ENGR155/macroprocessors/hardware.qmd

---
title: "Hardware"
description: "Selected electromagnet, sensor placement, and planned characterization."
---

## Electromagnet and Magnets

In the November 6 project discussion, the team selected the **Heyiarbeit JF-XP2520-12V**, described there as a 12 V DC, 25 mm diameter × 20 mm electromagnet. This replaces the hypothetical wound air-core coil used in earlier calculations. Selection does not establish measured lifting force, current, inductance, or thermal performance.

The team specified a **3/4 inch × 1/16 inch N42 fixed helper magnet** (approximately 19.05 mm × 1.59 mm). The suspended payload magnet was still undecided in that discussion. The moving magnet, carrier, and object together must total 10 g under the proposal.

Mount two Hall sensors above and below the electromagnet. Final helper-magnet placement, polarity, fit with the enclosed electromagnet, sensor saturation, and payload orientation need checking on the assembly.

## Course Boards and Planned Electronics

| Function | Board or planned part | Remaining check |
|---|---|---|
| Acquisition, DMA, gap estimate, web interface | STM32L432KC and course ESP8266 | Revised integration |
| Position PI and PWM | UPduino v3.1 | Revised controller |
| Field measurements | Two DRV5055 Hall sensors | Sensitivity and usable range |
| Three analog channels | MCP3204 at 3.3 V | Scan timing and noise |
| Current measurement | INA240A1 and 0.100 ohm shunt | Offset, gain, and heating |
| Power stage | UCC27511, MOSFET, flyback diode/clamp | Final ratings and wiring |
| Independent shutdown | E-stop and overcurrent comparator | Physical shutdown |
| Structure | Nonmagnetic frame, upper stop, catch tray | Final assembly evidence |

A gain of 20 and 0.100 ohm shunt give an ideal 2 V/A scale, or approximately 0.403 mA per 3.3 V, 12-bit ADC count. This is calculated scaling, not measured current accuracy.

## Characterization

Measure force versus gap and current with the complete assembly, including the helper magnet. Record cold/hot resistance, inductance, operating current, sensor headroom, and temperature. A contact holding-force rating does not establish force at a 10–20 mm gap.

The proposal's 500-turn, 8 ohm air-core example does not describe the selected electromagnet. Its calculated 1.178 A at 10 mm center distance must not be used as this device's measured operating current.

The [candidate BOM](hardware/bom.csv) and [earlier netlist](hardware/netlist.md) need reconciliation with final hardware. The proposal's $49 total is a planning allowance, not an updated purchase total. Final schematic, payload details, assembly photographs, and measured ratings remain to be added.
