ENGR155/macroprocessors/about.qmd

---
title: "About"
description: "Authors and scope of the ENGR 155 magnetic levitation project."
---

## The Project

This is our project for ENGR 155 at Harvey Mudd College. We are using the course MCU, FPGA, and ESP8266 boards to design a system that controls the height of a suspended magnetic object. The [system design](design.qmd) explains how we divide the work between the boards.

## Authors

### Stephen Kanti Mahanty

Stephen studies engineering at Harvey Mudd College and is interested in electrical and computer engineering. His experience includes PCB design and wireless networking, as well as an Electrical and Communications Engineering internship at Argonne National Laboratory.

[E155 Portfolio](https://stephenthecoder.github.io/engr155-portfolio/) | [GitHub](https://github.com/StephenTheCoder) | [LinkedIn](https://www.linkedin.com/in/stephen-kanti-mahanty/)

### Ben Lertwachara

Ben is a computer science major at Harvey Mudd College. His E155 portfolio contains his lab reports for the course.

[E155 Portfolio](https://jebeandiah.github.io/hmc-e155-portfolio/) | [GitHub](https://github.com/jebeandiah) | [LinkedIn](https://www.linkedin.com/in/benjamin-lertwachara-0b8251288/)

## Acknowledgements

The course materials and manufacturer datasheets are listed in the [technical references](docs/references.qmd). We used Codex to help prepare the implementation, documentation, and website. The [AI Use](ai.qmd) page describes this assistance.

## Website

This website is built with Quarto. Its layout follows the E155 course website and Carlos and Maynor's project website. The pages summarize the project, with links to more detailed engineering notes and source files.

[References](references.qmd)
