ENGR155/macroprocessors/docs/midpoint.md

# Midpoint status report framework

Current factual status: C firmware, HDL, protocol, tests, and implementation documentation are prepared. Parts are unselected and hardware operation has not been demonstrated. This status does not meet the working-hardware midpoint gate yet.

Prepare the course-length midpoint narrative with these sections, using actual dates and evidence:

1. Specifications and scope agreed with the instructor; any renegotiated interval or object.
2. Current functioning hardware and measured performance, with instrument captures.
3. MCU routine flow and FPGA acquisition/control diagram from docs/design.md.
4. A labeled CAD schematic of every assembled circuit, including interlocks and supplies.
5. The riskiest issue: Hall observability and transient compensation; current findings and next experiment.
6. Remaining work, owner, estimate, and dependency for each item in docs/course.md.

Append the relevant C and/or HDL source and explain how the demonstrated configuration was built. Keep absent measurements explicitly marked “not measured” rather than estimating completion percentages from file count. Preserve raw data and note firmware/FPGA configuration for reproducibility.
