ENGR155/macroprocessors/Project Proposal.docx

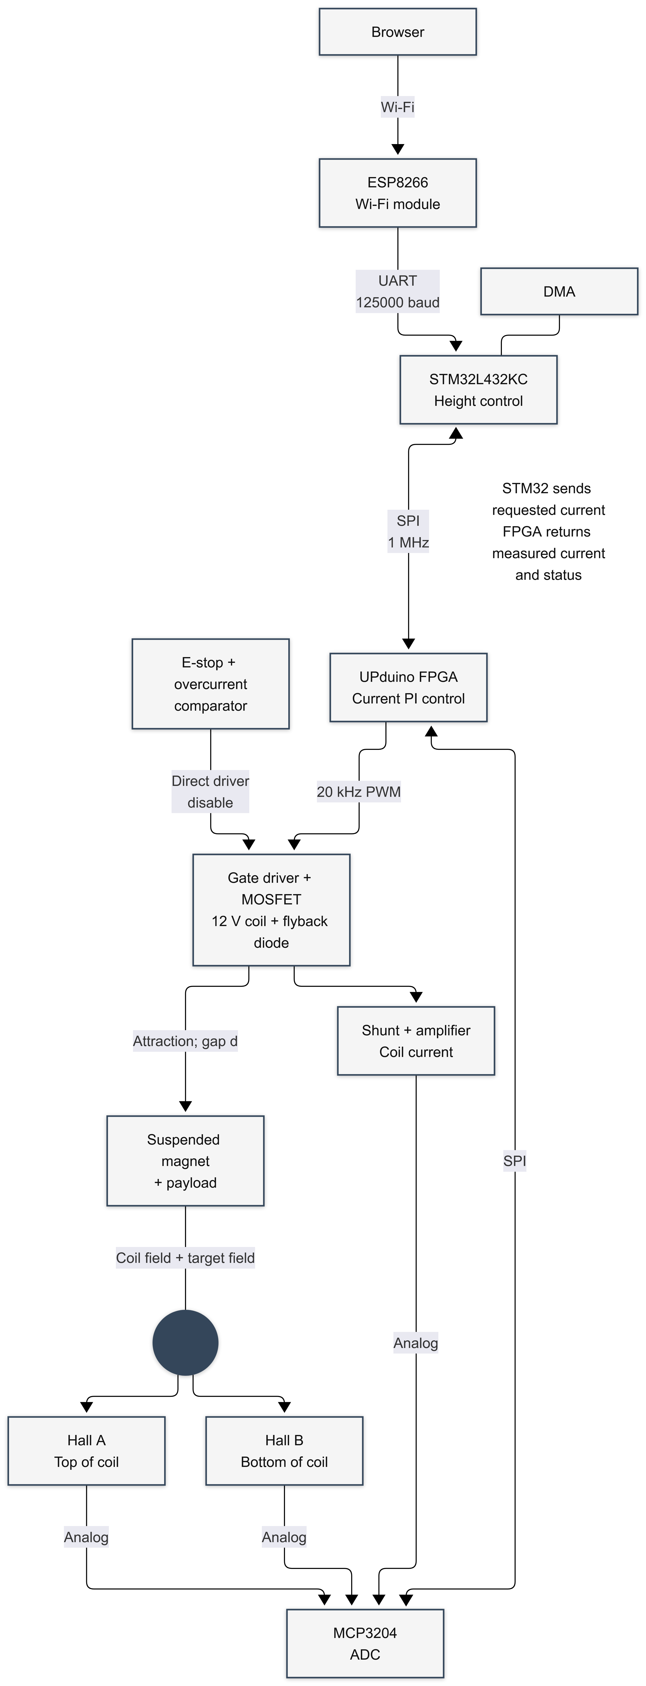
[picture p1: figure]

# Magnetic Levitation Project Proposal

Stephen Kanti Mahanty and Ben Lertwachara | ENGR 155

# Project overview

Our project will suspend a permanent magnet carrying an object below an electromagnet. The magnet, carrier and object will total 10 g. The webpage will command motion between 10 and 20 mm surface gaps. Two Hall sensors, mounted on opposite sides of the electromagnet, will measure magnetic field. We will combine both readings with measured coil current to estimate the target’s height and adjust current to hold it in place.

We will use the STM32L432KC MCU, UPduino FPGA and course ESP8266 Wi-Fi module. Gap d is the distance from the bottom of the coil to the top of the suspended magnet. We will demonstrate the round trips and position tolerance listed in the specifications and check gap with a ruler. The webpage will display requested gap, estimated gap, current and faults, and include a stop button.

# MCU and FPGA design

We will use shared control. The MCU will read the MCP3204 ADC over SPI using three separate channels: Hall sensor A, Hall sensor B and coil current. A timer will start scans at 5 kHz, with DMA moving SPI data. At 1 kHz, the MCU will estimate gap and use position and motion feedback to request a current. USART1 will connect to the ESP8266 at 125000 baud.

The MCU will send measured and requested current to the FPGA over SPI. The FPGA will run a 5 kHz PI current controller using DSP blocks and generate 20 kHz PWM. It will turn off drive after 50 ms without valid commands. A MOSFET, gate driver and flyback diode will switch the 12 V coil; a shunt and amplifier will measure current. An E-stop and overcurrent comparator will disable the driver directly. The MCU will also provide a drive-permit signal. SPI DMA is our new MCU peripheral use; the DSP current controller is our new FPGA logic; the ADC and magnetic sensing circuit are our new external hardware.

The MCU will read all three ADC channels and send measured and requested current to the FPGA. The FPGA will control current and generate PWM, as shown below.

SPI links carry commands and replies. The MCU drive-permit signal also gates the driver. Logic uses 3.3 V and shares ground with the coil circuit.

# Biggest challenge

Our biggest challenge is separating the target’s field from the coil’s field. We will mount Hall sensors A and B on opposite sides of the electromagnet and calibrate both readings at known gaps and coil currents on a plastic fixture. The MCU will read the sensors on separate ADC channels, combine their readings in software and compensate for the coil field using measured current. We will verify the estimated gap against ruler measurements over the 10–20 mm operating range. The ADC’s limited differential mode cannot directly subtract both full Hall outputs. A catch tray and upper stop will protect against falls and the target snapping upward.

# Current needed to lift an object at 12 V

Voltage alone does not tell us how much weight we can lift. We need the total mass m of the magnet, carrier and object, plus the coil geometry and magnet strength. For a first estimate, assume a small aligned permanent magnet below a thin air-core coil. Let N be the number of turns, a the mean coil radius, μ the magnet’s dipole moment and z the distance from the coil plane to the magnet’s center. Use meters and kilograms in the equations.

The coil field is B(z) = μ₀NIa² / [2(a² + z²)³ᐟ²]. The upward force is approximately F = μ|dB/dz| = K(z)I, where:

K(z) = 3μ₀Nμa²z / [2(a² + z²)⁵ᐟ²] and Ihold(z) = mg / K(z).

Here μ₀ = 4π × 10⁻⁷ H/m and g = 9.81 m/s². To move up by x mm from z₀, the final distance is z₁ = z₀ − x/1000. Current must provide enough force throughout the move, not just at the endpoint. To accelerate upward at aup, use I = m(g + aup)/K(z). The center distance z is different from surface gap d; we will convert between them using the actual coil and magnet dimensions.

## Example for a 10 g magnet and payload

For a sizing calculation, use N = 500 turns, a = 10 mm, μ = 0.050 A·m² and coil resistance R = 8 Ω. These are calculation assumptions, not selected parts. The table covers center distances of 10–20 mm; actual center distances will include the coil and magnet offsets from surface gap d. With PWM, duty cycle is D ≈ IR/12 and coil heating is P = I²R.

Final distance z | Holding current | 12 V duty | Coil heating
20 mm | 5.819 A | 388% | 270.9 W
15 mm | 2.643 A | 176% | 55.9 W
10 mm | 1.178 A | 79% | 11.1 W

For this example, 12 V / 8 Ω = 1.50 A is the ideal full-on current limit. Holding at z = 20 mm requires 5.819 A, so this example coil cannot deliver the required range at 12 V. A 10 mm upward move from z = 20 to 10 mm requires the largest holding current at the start. For a one-second move with equal acceleration and deceleration, aup = 4(0.010)/1² = 0.040 m/s²; the initial current becomes 5.842 A. A duty above 100% in the table means the supply cannot provide the required current.

We will select the final coil and magnet using measured force versus gap and current. The assembly must support the 10 g target over the full 10–20 mm surface-gap range at 12 V. We will measure hot resistance, inductance and temperature and check that the supply covers IR + L(dI/dt) and circuit losses. An iron core and finite magnet dimensions change the simple air-core estimate. Stable suspension will be verified by the demonstration specifications.

## Timing and measurement calculations

At 1 MHz SPI, a 24-clock ADC reading takes 24 μs. Including a 1 μs gap, current plus two Hall readings takes 75 μs. An 8-byte FPGA exchange takes about 68 μs with chip-select gaps. Together this uses 143 μs of a 200 μs scan period, leaving 57 μs for setup and processing. We will check the actual timing with a logic analyzer.

The 12-bit ADC has 4096 levels: 3.3 V / 4096 = 0.806 mV per count. With a 0.100 Ω shunt and gain of 20, current resolution is about 0.403 mA per count. At 1.18 A the shunt dissipates 0.139 W. A 24 MHz FPGA clock divided by 1200 gives 20 kHz PWM.

Stability calculation:

Assume a 10g mass held 15 mm below the coil. At the stationary position, acceleration is 0 and force is F = mg = 0.0981N. We set gap error x = d – 0.015 (d is gap in meters) and accumulated gap error η as the integral of x. We request current as iref = i0 + Kpx + Kiη

Current error is ei = iref – imeas so we request PWM duty as u = u0 + Kp(iref – i) + KI*(integral of iref - i)

If there is first-order lag with τ = 1 ms, then we have 0.001s³ + s² + 126.4s + 6400 = 0, which is stable as per the Routh-Horwitz definition of stability (all poles have negative real parts). We

Position Resolution – how closely we can see where it is

Stability – how closely we want it to be stable (calculations for loop) – start with continuous updates and find small signal gain, find out what happens when you transform – oppenheim and wilsky might have it

# Project specifications

These are proposed demonstration targets. We will use one magnet, carrier and object totaling 10 g. Professors can check each box during the demonstration using a ruler, stopwatch, webpage and scope or logic analyzer. Excellence includes all proficiency checks.

## Hardware and levitation specifications

## Proficiency

☐ Use the webpage to move from 20 to 10 mm and back five times without contact.

## Excellence

☐ Complete five 20-to-10 mm round trips, reaching within ±5 mm of each requested gap.

## Control and webpage specifications

## Proficiency

☐ Show requested gap, estimated gap, coil current and fault state on the webpage real-time on a graph (no visible latency between controlled object and the graph).

## Excellence

☐ Demonstrate visible noticeable movement of magnet through webpage control across controllable range.

Make specs for 1 specific mass

Maybe update constants from webpage(?)

# Bill of materials and budget

Parts | Planned cost
NUCLEO-L432KC, UPduino, ESP8266; bench supply and frame | Course kit / stockroom*
2 DRV5055 Hall sensors; MCP3204 ADC; INA240A1 amplifier | $16
0.100 Ω 1 W shunt; UCC27511 driver; MOSFET; flyback diode | $6
Coil, magnet and carrier; adapters, resistors and capacitors | $14
Fuse and connectors*; shipping and tax allowance | $3 + $10
Estimated total | $49

*Stockroom availability is unconfirmed. Costs are allowances; final coil and power-switch parts depend on testing.

# Schedule and division of work

Week | Stephen | Ben
1–2 | Measure coil force; build driver and FPGA PWM | Read ADC; calibrate Hall and current readings
3–4 | Tune FPGA current PI; build frame and stops | Validate gap estimate; tune MCU height control
5–6 | Webpage, shutdown tests and schematic | Motion tests, checkoff measurements and report
