ENGR155/macroprocessors/overleaf_10mm/calculation_summary.pdf

## Magnetic Levitation at a Nominal 10 mm Distance

Abridged Calculation: Position PI Driving PWM Directly

ENGR 155 calculation notes

Result. Reducing the distance improves the available lifting force. For the proposal’s illustrative coil, a 10 mm center distance requires about 1.178 A and 78.5% ideal duty at 12 V. However, assuming an inductance of 10 mH and negligible passive mechanical damping, the position PI loop remains unstable for every choice of PI gains in the continuous-time model derived below. The inductance and damping are assumptions, not measurements.

## 1 Geometry, architecture, and assumptions

The suspended magnet, carrier, and payload have total mass m = 0.010 kg. The desired surface gap is d0 = 0.010 m, measured from the lower coil face to the upper magnet face. The thin-coil/dipole model instead uses the distance z from the coil plane to the magnet center:

z = d + ∆g, | z0 = d0 + ∆g. | (1)

For a coil represented by its axial midplane and a magnet represented by its geometric center, ∆g is approximately half the coil thickness plus half the magnet height. Its value must be determined from the actual geometry.

Distance convention for the numbers below. To reproduce the current 10 mm calculation, the numerical illustration sets z0 = 10 mm. This equals a 10 mm surface gap only in the zero-offset, thin-coil/point-magnet idealization. For a real 10 mm surface gap, substitute the actual z0 = 10 mm + ∆g into the same equations.

The controller is position PI only: measured gap error produces PWM duty directly. There is no current reference or current-feedback controller. Current can still be measured for field compensation, telemetry, and protection. The FPGA executes the position PI and PWM; the MCU handles ADC acquisition, DMA, the gap estimate, and the web interface through the Wi-Fi module.

The numerical sizing assumptions from the proposal are

Symbol | Meaning | Value used
m | Total suspended mass | 0.010 kg
g | Gravitational acceleration | 9.81 m/s

2
N | Coil turns | 500
a | Mean coil radius | 0.010 m
µ | Magnet dipole moment | 0.050 A m²
R | Coil resistance | 8.0 Ω
Vs | Supply voltage | 12.0 V
L | Differential coil inductance | 0.010 H, assumed
c | Passive mechanical damping | 0 N s/m, approximation

The model assumes an aligned permanent dipole, a thin air-core coil, small motions near equilibrium, and an averaged PWM voltage Vsu in continuous conduction. It neglects driver and diode drops, thermal changes, magnetic saturation, hysteresis, and unmodeled structural motion. A final core-equipped coil must be characterized locally rather than assigned these air-core slopes.

## 2 Holding force, current, and power

The standard axial coil field and aligned-dipole approximation give

B(z) = µ0NIa²
2(a

2 + z

2)

3/2

, | | (2)

F(z, I) ≃ µ

dB
dz
= K(z)I, | | (3)

K(z) = 3µ0Nµa²
z
2(a

2 + z

2)

5/2

, | µ0 = 4π × 10−7 H/m. | (4)

The field expression follows the current-loop model in OpenStax [1]; the force relation is the dipole approximation used in the proposal. At z0 = 0.010 m,

K(z0) = 0.0833041 N/A, | (5)
F0 = mg = 0.0981 N, | (6)

i0 =

mg
K(z0)
= 1.17761 A, | (7)

u0 ≃

Ri0
Vs
= 0.78508, | (8)

Pcoil = i

2
0R ≃ 11.09W. | (9)

The ideal full-on current is Vs/R = 1.50 A, so this nominal point is statically feasible in the ideal model. It leaves about 21.5 percentage points of upward duty headroom; it does not establish thermal acceptability, dynamic force headroom, or closed-loop stability.

## 3 Small-signal force gains and mechanics

Define x = d − d0 and j = i − i0. Positive x is downward motion, away from the coil. A first-order Taylor expansion of upward magnetic force is

F ≃ mg − kxx + kf j, | kf =
| ∂F ∂i
| 0
, | kx = −
| ∂F ∂d
0
. | (10)

Because z = d + ∆g with fixed geometry, dz/dd = 1. For the illustrative force law,

kf = K(z0), | | (11)
dK
dz

= K(z)

1
z

−

| 5z a 2 + z
| 2
| , | (12)
kx = mg
5z0
a | 2 + z

2/0−

| 1 z0
| . | (13)

Substitution gives
kf = 0.0833041 N/A, | kx = 14.715 N/m. | (14)

Newton’s law, with downward displacement positive, is

mx¨ + cx˙ − kxx + kf j = 0. | (15)

If current were held fixed and c = 0, the mechanical poles would be s = ±

p
kx/m = ±38.36 s−1
. The
positive pole represents a growing displacement. This is a fixed-current mechanical comparison, not the complete voltage-driven plant.

## 4 Position PI and the uncontrolled coil current

Let u ∈ [0, 1] be duty fraction. For a constant target define

u = u0 + Kpx + Kiη, | η˙ = x. | (16)

The positive sign increases attraction when the object is too far from the coil. Kp has units m−1
| | , Ki has
units m−1
s

−1
, and η has units m s. For a changing requested gap r(t), the controller error is e = d − r.

Coil current is a plant state, even though it has no controller. Including motion-induced voltage, the local electrical equation is

L˙j + Rj − kfx˙ = Vsδu, | δu = u − u0. | (17)

The coupling term follows from reciprocal magnetic coenergy: the downward magnetic force is −F, so ∂λ/∂d = ∂(−F)/∂i = −kf , where λ is flux linkage. Consequently δv = Rj + L˙j − kfx˙. This is the energy-based electromechanical modeling method in Woodson and Melcher [2]. The mechanical damping c excludes this explicitly modeled coil coupling. If motion-induced voltage is negligible, omit the −kfx˙ term; then the +k

2
f

term below also disappears.

## 5 Laplace transform and stability calculation

With zero initial conditions, the transformed equations are

(ms² + cs − kx)X + kfJ = 0, | (18)
(Ls + R)J − kf sX = Vs∆U, | (19)

∆U =

| Kp + Ki s
X. (20)

Eliminating J and ∆U gives

s

(ms² + cs − kx)(Ls + R) + k

2
f

s

+ kfVs(Kps + Ki) = 0. | (21)

Thus the characteristic polynomial is

p(s) = mLs⁴ + (mR + cL)s

3 + (cR − kxL + k

2
f

)s

2

+ (kfVsKp − kxR)s + kfVsKi .

(22)

The four states are position, velocity, current, and accumulated position error. Taking a transform changes the representation, not the physical stability. Laplace and feedback foundations are in Oppenheim and Willsky [4].

For p(s) = A4s

4 + A3s

3 + A2s

2 + A1s + A0, strict stability requires

A4, A3, A2, A1, A0 > 0, | (23)
A3A2 − A4A1 > 0, | (24)

A3A2A1 − A4A

2
1 − A

2
3A0 > 0. | (25)

These are the quartic Routh–Hurwitz conditions [3]. Two necessary conditions are

Kp >

kxR
kfVs

, cR + k

2
f > kxL. | (26)

The second condition is independent of the PI gains.

For L = 10 mH and c = 0, the numerical polynomial is

p(s) = 0.0001s

4 + 0.08s

3 − 0.140210s

2

+ (0.999649Kp − 117.72)s + 0.999649Ki .

(27)

Its s

2
coefficient is negative for every Kp, Ki

. Therefore no position PI tuning can make this particular continuous-time model strictly stable. The necessary proportional-gain threshold, Kp > 117.76 m−1 ,
cannot repair the negative coefficient.

For illustration only, choose Kp = 150 m−1 and Ki = 100 m−1
s

−1
. Then

p(s) = 0.0001s

4 + 0.08s

3 − 0.140210s

2 + 32.2273s + 99.9649, | (28)

whose roots are
s = −802.247, | −2.9963, | 2.6214 ± j 20.2237 s−1
. | (29)

The oscillatory mode grows as e

2.6214t
, with an amplitude e-folding time of about 0.381 s. These are unstable example gains, not recommended firmware settings.

The necessary electrical/damping condition can also be written

c = 0 : | L < k
| 2 f kx
= 0.4716 mH, | (30)
L = 10 mH : | c >

kxL − k

| | 2 f
| R
= 0.01753 N s/m. | (31)

Passing either applicable threshold is necessary but not sufficient: all Routh inequalities must still pass. This does not prove that every physical PI-controlled levitator is unstable; it identifies what this assumed plant cannot achieve.

## 6 Digital implementation and the z-transform

For an illustrative 1 kHz position update, T = 0.001 s, choose the explicit timing convention

δu[k] = Kpe[k] + Kiη[k], | (32)
η[k + 1] = η[k] + T e[k]. | (33)

This gives C(z) = Kp + KiT /(z −1). Using the updated accumulator in the same sample instead would give a different discrete controller.

To check the held actuator correctly, define q = [x, x, j ˙ ]

T:

q˙ = Aq + Bδu, A =

0 | 1 | 0
kx/m −c/m −kf /m
0 | kf /L | −R/L
- , B =

0
0
Vs/L
- , C =

h

1 0 0i
. (34)

The exact zero-order-held plant has

Ad = e

AT , | Bd =

Z T

0

e

| | AτB dτ, | (35)

and the sampled closed-loop state matrix, with zero additional computation delay, is

M =

"
Ad + BdKpC BdKi
| T C | 1

| | . | (36)

The implemented loop is stable only if every eigenvalue of M is inside the unit circle. Merely substituting z = e

sT for the continuous closed-loop poles does not model a separately sampled controller and held actuator. Additional sensor filtering, communication, and computation delay must be included before selecting firmware gains.

For the same illustrative plant and the unstable example gains above, the eigenvalues of this sampled matrix are
z = 0.447767, | 0.997019, | 1.002880 ± j 0.020241. | (37)

The complex pair has magnitude approximately 1.00308, exceeding one. Thus the explicitly defined 1 kHz sampled implementation is also unstable.

## 7 Measurements and the position-tolerance requirement

For the final coil at the actual 10 mm surface gap, measure the holding current and hot resistance, differential inductance, and local force slopes:

kf ≃

F(d0, i0 + ∆i) − F(d0, i0 − ∆i) 2∆i

| | , | (38)
kx ≃ −

F(d0 + ∆d, i0) − F(d0 − ∆d, i0)
| | 2∆d
| | . | (39)

Estimate passive damping without counting the modeled coil-induced damping twice. Recalculate the continuous and sampled poles with the measured values. Duty limits and integrator anti-windup are necessary practical details, but they do not turn an unstable linear PI design into a stable small-signal loop.

Specify a true-position tolerance and a recovery time separately; for example, |d − r| ≤ 0.5 mm after a defined disturbance and settling interval. That example is not a demonstrated performance claim. A stable, unsaturated PI loop can reject constant disturbances in its measured position, while sensor bias, noise, quantization, and saturation still limit the true position. The proposal’s current demonstration band is ±5 mm. No settling time or position band can be certified from the unstable example above.

## References

[1] OpenStax, University Physics, Volume 2, Sec. 12.4, “Magnetic Field of a Current Loop.” https://openstax.org/books/university-physics-volume-2/pages/12-4-magnetic-field-of-a-current-loop (https://openstax.org/books/university-physics-volume-2/pages/12-4-magnetic-field-of-a-current-loop)
[2] H. H. Woodson and J. R. Melcher, Electromechanical Dynamics, Part I, Chs. 3 and 5. MIT OpenCourseWare. https://ocw.mit.edu/courses/res-6-003-electromechanical-dynamics-spring-2009/pages/part-i/ (https://ocw.mit.edu/courses/res-6-003-electromechanical-dynamics-spring-2009/pages/part-i/)
[3] University of Illinois, ECE 486 Handbook, Lecture 7, “Routh–Hurwitz Stability Criterion.” https: //courses.physics.illinois.edu/ece486/sp2026/documentation/handbook/lec07.html
[4] A. V. Oppenheim, A. S. Willsky, with S. H. Nawab, Signals and Systems, 2nd ed., Prentice Hall, 1997, Chs. 9 (Laplace), 10 (z-transform), and 11 (feedback). MIT reading guide: https://ocw.mit.edu/courses/6-003-signals-and-systems-fall-2011/pages/readings/
