ENGR155/macroprocessors/overleaf_10mm/assets/system_architecture.png

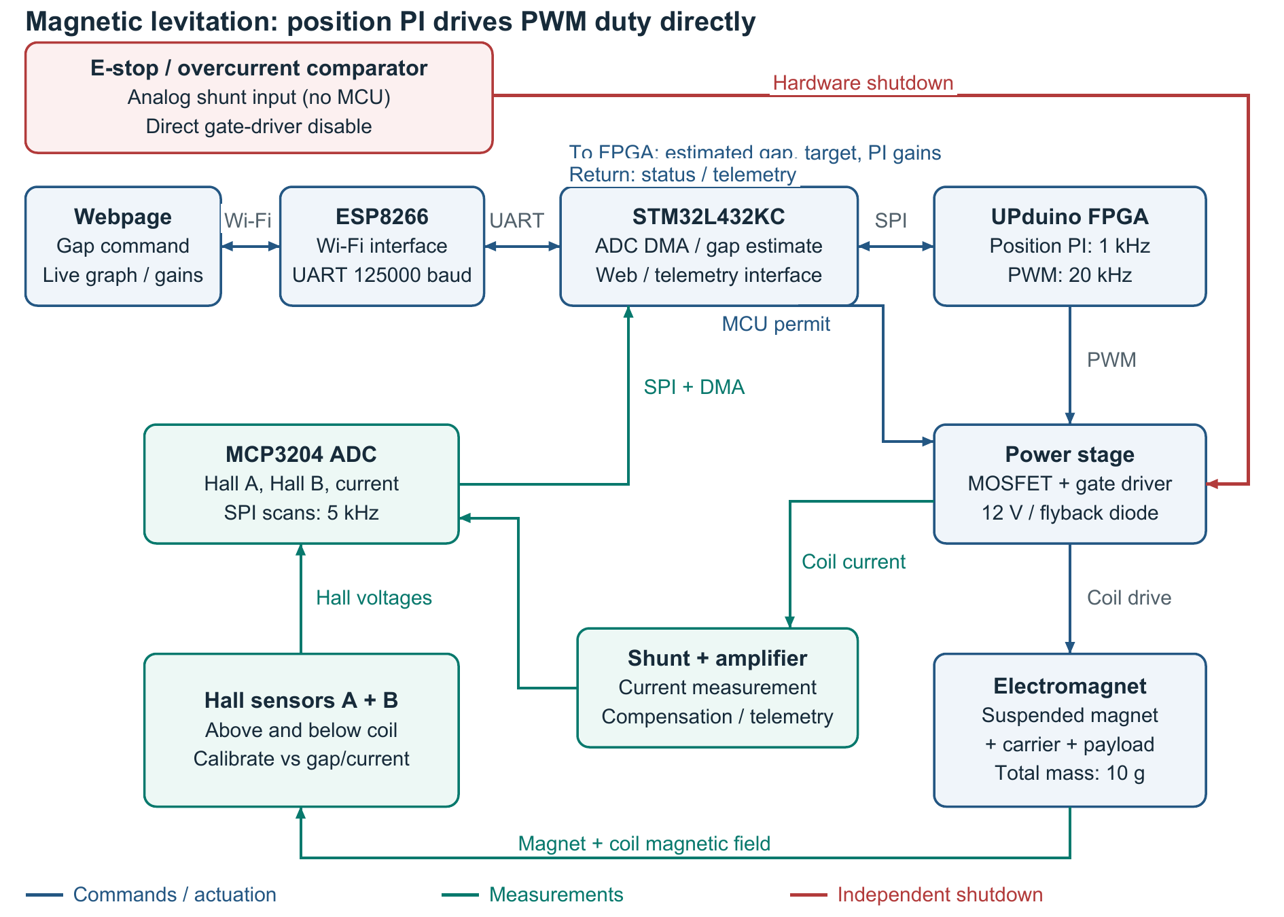
overleaf_10mm/assets/system_architecture.png
