ENGR155/macroprocessors/cad/testbox1_box/fabricated_parts_assembled.step

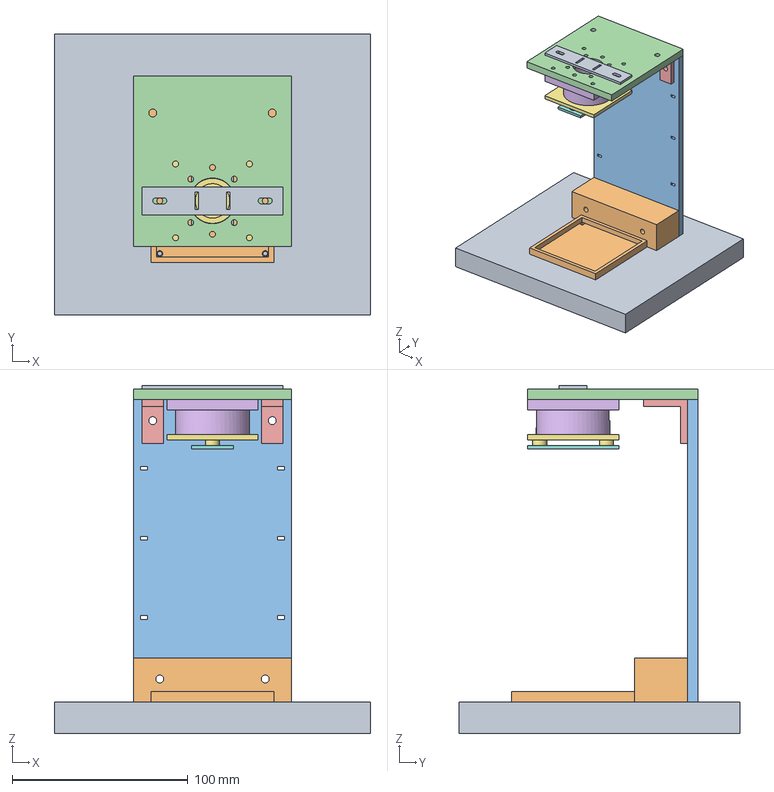
[picture p4: CAD file, 2026-11-11]
cad/testbox1_box/fabricated_parts_assembled.step
180.0 x 160.0 x 198.0 mm
