ENGR155/macroprocessors/cad/testbox1_box/parts/REF_upper_Hall_allowance.step

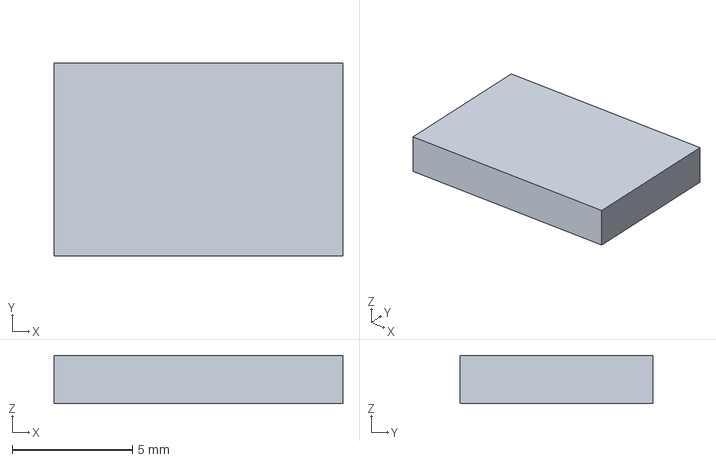
[picture p5: CAD file, 2026-11-11]
cad/testbox1_box/parts/REF_upper_Hall_allowance.step
12.0 x 8.00 x 2.00 mm
