ENGR155/macroprocessors/cad/testbox1_box/printed_version/parts/06_em_cradle.step

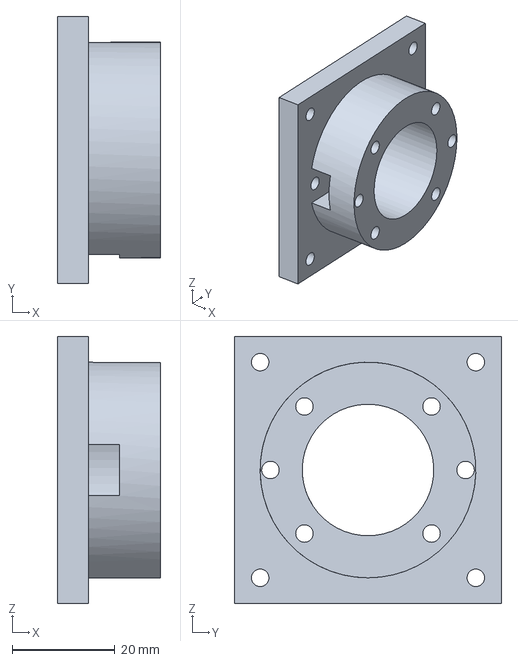
[picture p6: CAD file, 2026-11-11]
cad/testbox1_box/printed_version/parts/06_em_cradle.step
20.0 x 52.0 x 52.0 mm
