ENGR155/macroprocessors/cad/testbox1_box/parts/REF_helper_19p05x1p5875.step

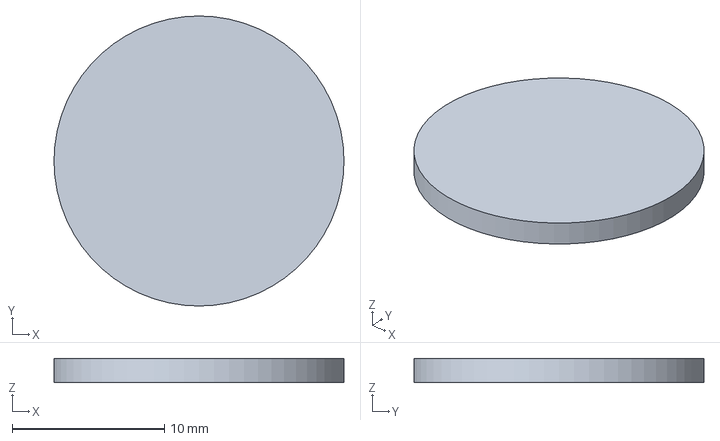
[picture p7: CAD file, 2026-11-11]
cad/testbox1_box/parts/REF_helper_19p05x1p5875.step
19.1 x 19.1 x 1.59 mm
