ENGR155/macroprocessors/cad/testbox1_box/printed_version/parts/05_angle_bracket_right.step

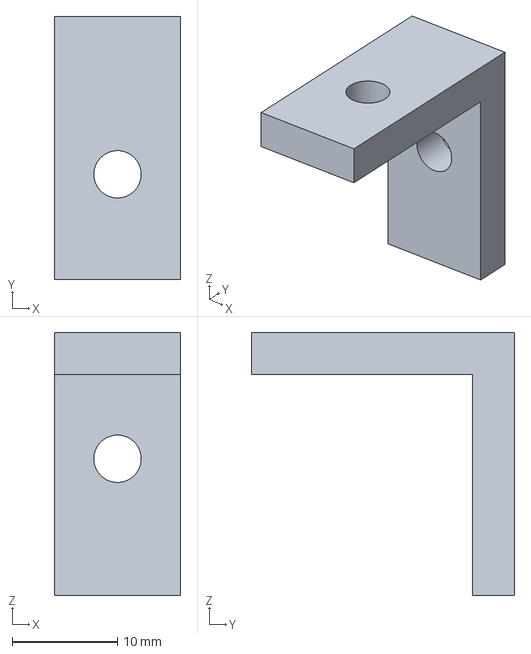
[picture p8: CAD file, 2026-11-11]
cad/testbox1_box/printed_version/parts/05_angle_bracket_right.step
12.0 x 25.0 x 25.0 mm
