ENGR155/macroprocessors/cad/testbox1_box/parts/04_clear_top_cantilever.step

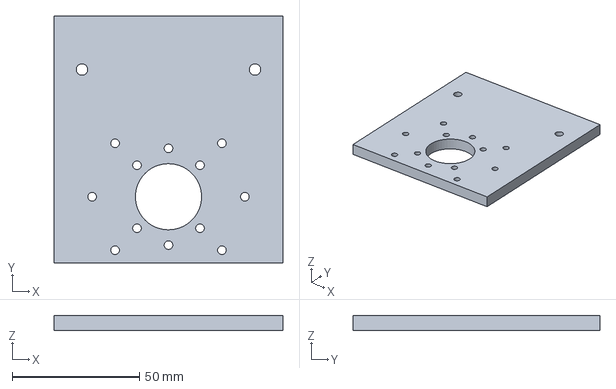
[picture p9: CAD file, 2026-11-11]
cad/testbox1_box/parts/04_clear_top_cantilever.step
90.0 x 97.0 x 6.00 mm
