ENGR155/macroprocessors/cad/testbox1_box/printed_version/parts/09_upper_Hall_carrier.step

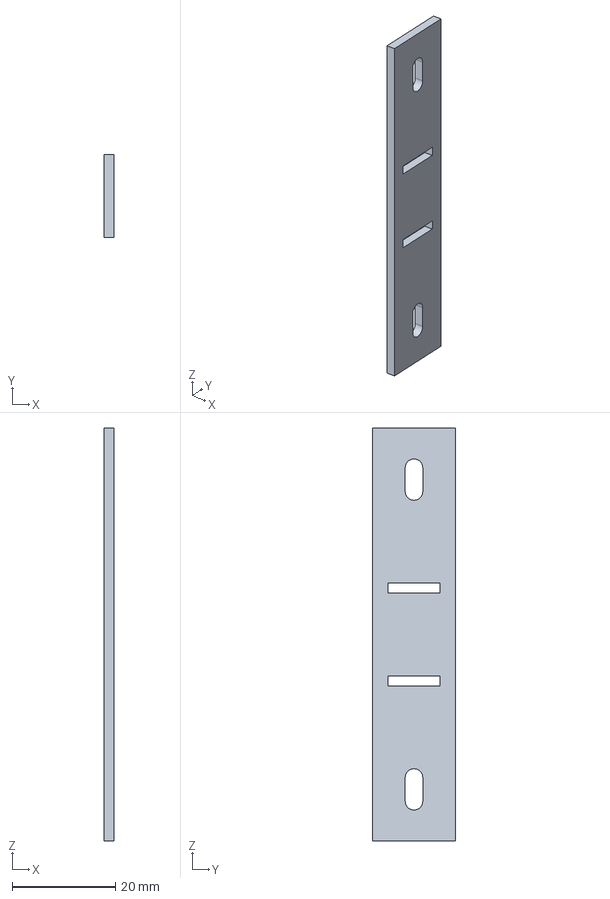
[picture p10: CAD file, 2026-11-11]
cad/testbox1_box/printed_version/parts/09_upper_Hall_carrier.step
2.00 x 16.0 x 80.0 mm
