ENGR155/macroprocessors/cad/testbox1_box/parts/REF_electromagnet_25x20.step

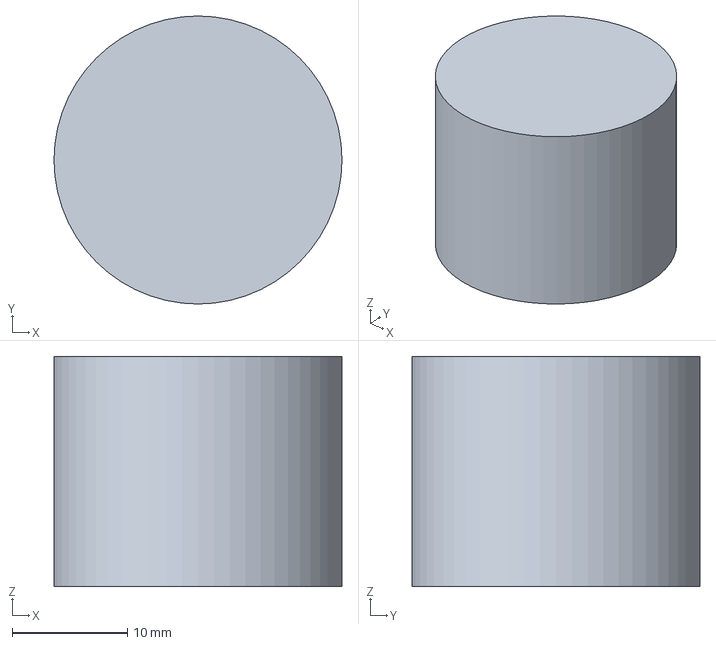
[picture p11: CAD file, 2026-11-11]
cad/testbox1_box/parts/REF_electromagnet_25x20.step
25.0 x 25.0 x 20.0 mm
