ENGR155/macroprocessors/cad/testbox1_box/parts/08_lower_Hall_guard.step

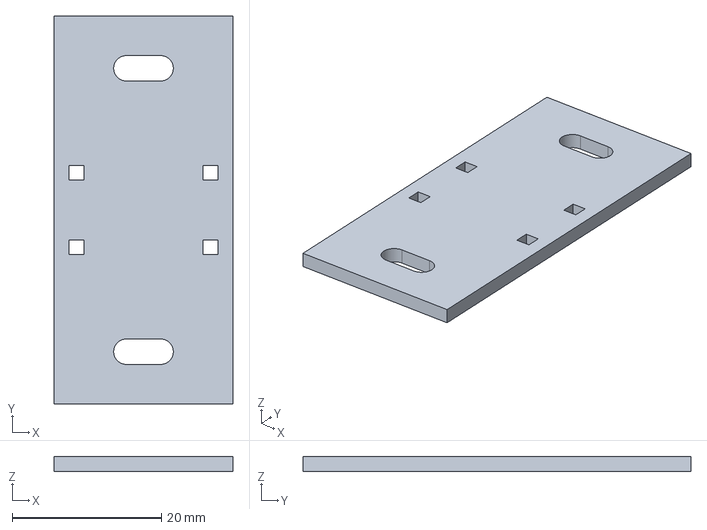
[picture p12: CAD file, 2026-11-11]
cad/testbox1_box/parts/08_lower_Hall_guard.step
24.0 x 52.0 x 2.00 mm
