ENGR155/macroprocessors/cad/testbox1_box/printed_version/parts/01_plywood_base.step

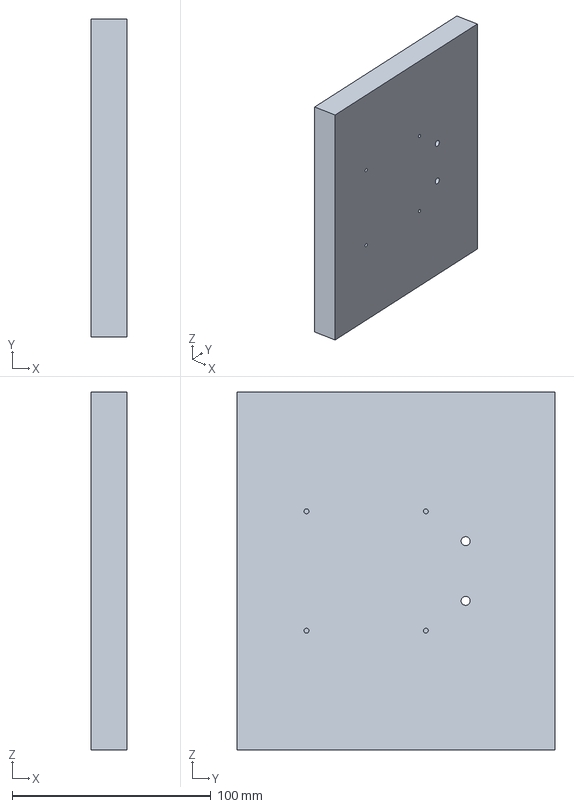
[picture p13: CAD file, 2026-11-11]
cad/testbox1_box/printed_version/parts/01_plywood_base.step
18.0 x 160.0 x 180.0 mm
