ENGR155/macroprocessors/cad/testbox1_box/parts/03_clear_rear_panel.step

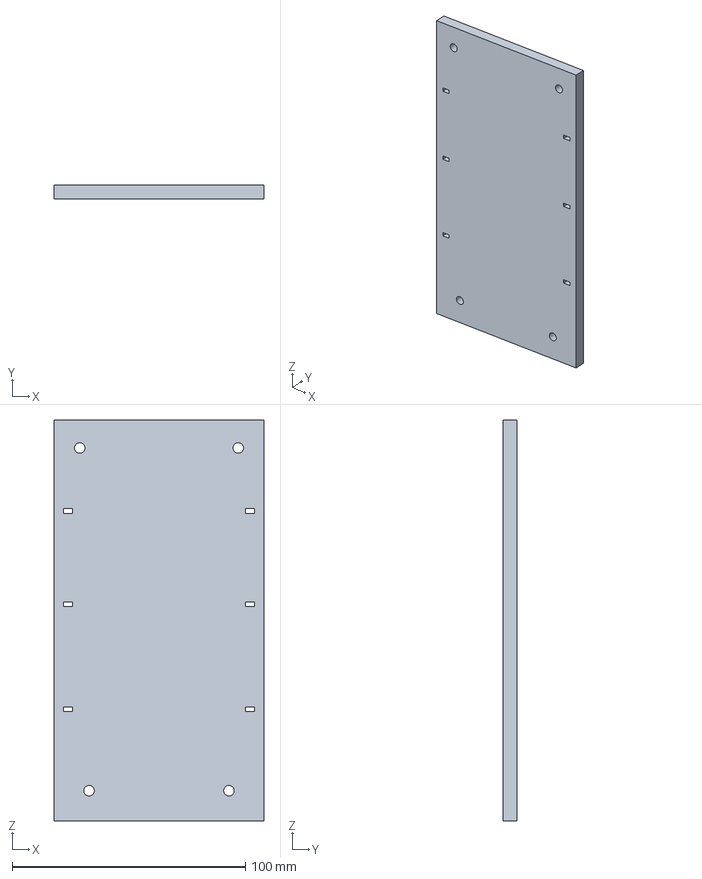
[picture p14: CAD file, 2026-11-11]
cad/testbox1_box/parts/03_clear_rear_panel.step
90.0 x 6.00 x 172.0 mm
