ENGR155/macroprocessors/cad/testbox1_box/parts/07_helper_retainer_cassette.step

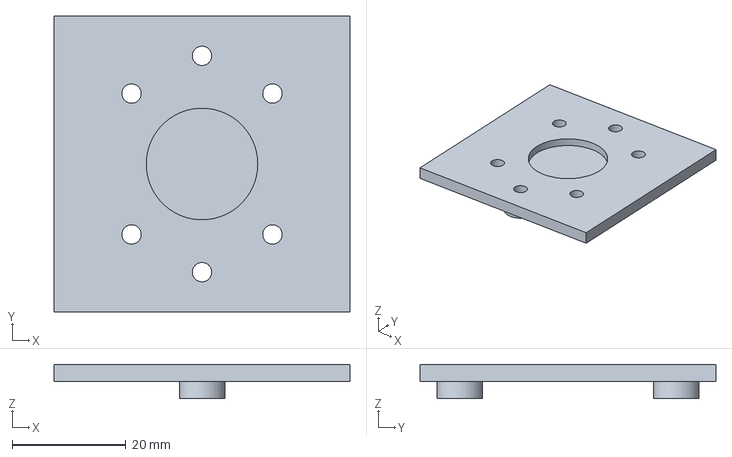
[picture p15: CAD file, 2026-11-11]
cad/testbox1_box/parts/07_helper_retainer_cassette.step
52.0 x 52.0 x 6.00 mm
