ENGR155/macroprocessors/cad/testbox1_box/printed_version/parts/10_catch_tray.step

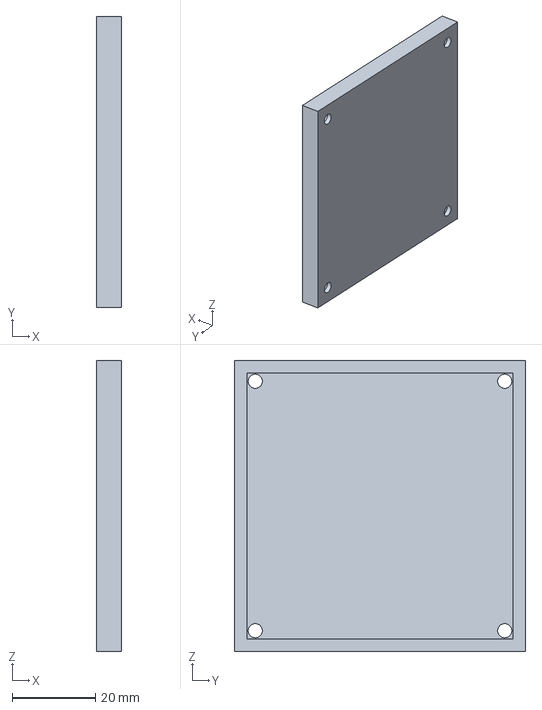
[picture p16: CAD file, 2026-11-11]
cad/testbox1_box/printed_version/parts/10_catch_tray.step
6.00 x 70.0 x 70.0 mm
