ENGR155/macroprocessors/cad/testbox1_box/parts/REF_payload_ASSUMED_12p7x6_gap15.step

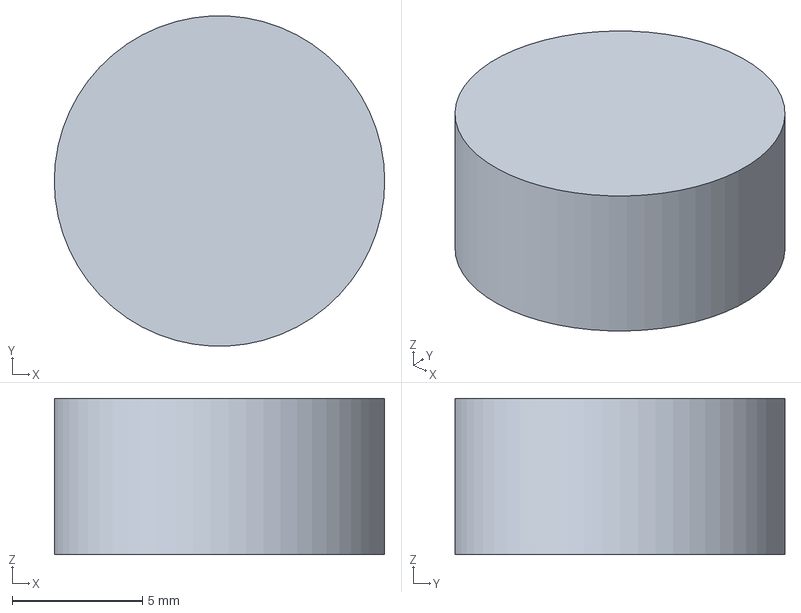
[picture p17: CAD file, 2026-11-11]
cad/testbox1_box/parts/REF_payload_ASSUMED_12p7x6_gap15.step
12.7 x 12.7 x 6.00 mm
