ENGR155/macroprocessors/cad/testbox1_box/printed_version/parts/02_wood_rear_clamp.step

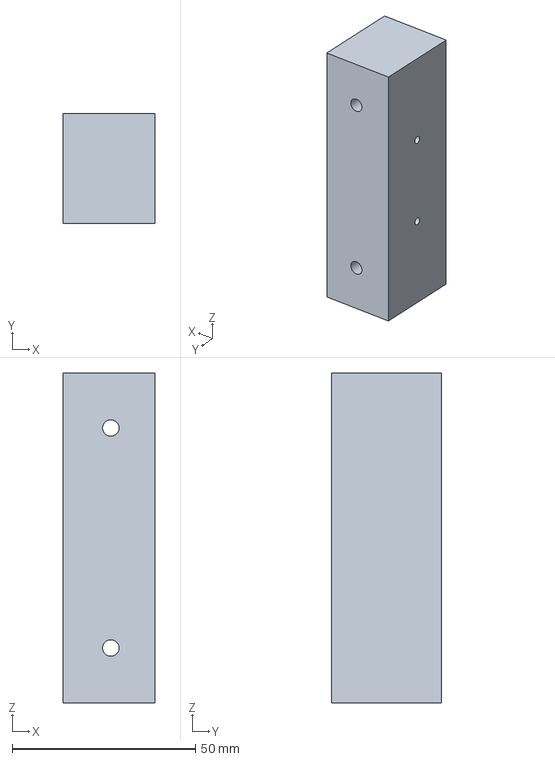
[picture p18: CAD file, 2026-11-11]
cad/testbox1_box/printed_version/parts/02_wood_rear_clamp.step
25.0 x 30.0 x 90.0 mm
