ENGR155/macroprocessors/(list of files, cad)

Other CAD files:
cad/testbox1_box/printed_version/testbox1_box_printable.step
cad/testbox1_box/testbox1_box_maglev.step
cad/testbox1_box/printed_version/parts/04_clear_top_cantilever.step
cad/testbox1_box/printed_version/parts/05_angle_bracket_left.step
cad/testbox1_box/printed_version/parts/08_lower_Hall_guard.step
cad/testbox1_box/parts/06_em_cradle.step
cad/testbox1_box/printed_version/parts/07_helper_retainer_cassette.step
cad/testbox1_box/parts/01_plywood_base.step
cad/testbox1_box/parts/05_angle_bracket_left.step
cad/testbox1_box/printed_version/parts/03_clear_rear_panel.step
cad/testbox1_box/parts/02_wood_rear_clamp.step
cad/testbox1_box/parts/REF_lower_Hall_allowance.step
cad/testbox1_box/parts/05_angle_bracket_right.step
cad/testbox1_box/parts/09_upper_Hall_carrier.step
cad/testbox1_box/parts/10_catch_tray.step
cad/testbox1_box/parts/01_plywood_base.stl
cad/testbox1_box/parts/02_wood_rear_clamp.stl
cad/testbox1_box/parts/03_clear_rear_panel.stl
cad/testbox1_box/parts/04_clear_top_cantilever.stl
cad/testbox1_box/parts/05_angle_bracket_left.stl
cad/testbox1_box/parts/05_angle_bracket_right.stl
cad/testbox1_box/parts/06_em_cradle.stl
cad/testbox1_box/parts/07_helper_retainer_cassette.stl
cad/testbox1_box/parts/08_lower_Hall_guard.stl
cad/testbox1_box/parts/09_upper_Hall_carrier.stl
cad/testbox1_box/parts/10_catch_tray.stl
cad/testbox1_box/printed_version/parts/01_plywood_base.stl
cad/testbox1_box/printed_version/parts/02_wood_rear_clamp.stl
cad/testbox1_box/printed_version/parts/03_clear_rear_panel.stl
cad/testbox1_box/printed_version/parts/04_clear_top_cantilever.stl
cad/testbox1_box/printed_version/parts/05_angle_bracket_left.stl
cad/testbox1_box/printed_version/parts/05_angle_bracket_right.stl
cad/testbox1_box/printed_version/parts/06_em_cradle.stl
cad/testbox1_box/printed_version/parts/07_helper_retainer_cassette.stl
cad/testbox1_box/printed_version/parts/08_lower_Hall_guard.stl
cad/testbox1_box/printed_version/parts/09_upper_Hall_carrier.stl
cad/testbox1_box/printed_version/parts/10_catch_tray.stl
