ENGR155/macroprocessors/cad/testbox1_box/dimensioned_assembly.pdf

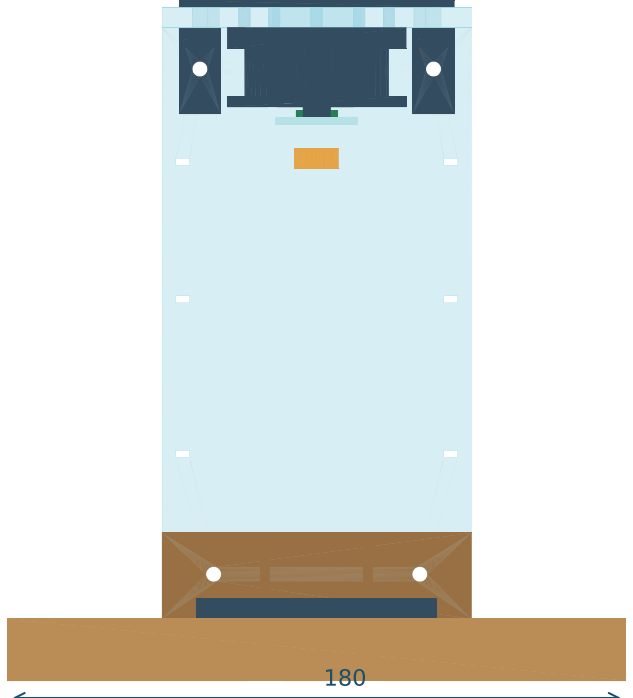
[picture p19: figure]

200 overall

90 panel width

## FRONT • X / Z

160

172 upright

97 cantilever

EM face Z170
10–20 surface gap
payload top Z160–150

## SIDE • Y / Z

# TESTBOX1 BOX • ASSEMBLY DIMENSIONS

All dimensions mm. CAD-derived projections. Base 18 thick; clear sheets 6 thick. EM bore25.6; helper pocket Ø19.6 × 1.9 deep. Guard underside Z162: 2mm nominal clearance to payload at10mm gap. Helper modeled Z168.1: helper-to-payload gap8.1–18.1mm.

ASSUMED payload Ø12.7 × 6 shown at15mm surface gap. Confirm purchased payload and Hall package before fabrication.
