ENGR155/macroprocessors/cad/testbox1_box/assembly_preview.png

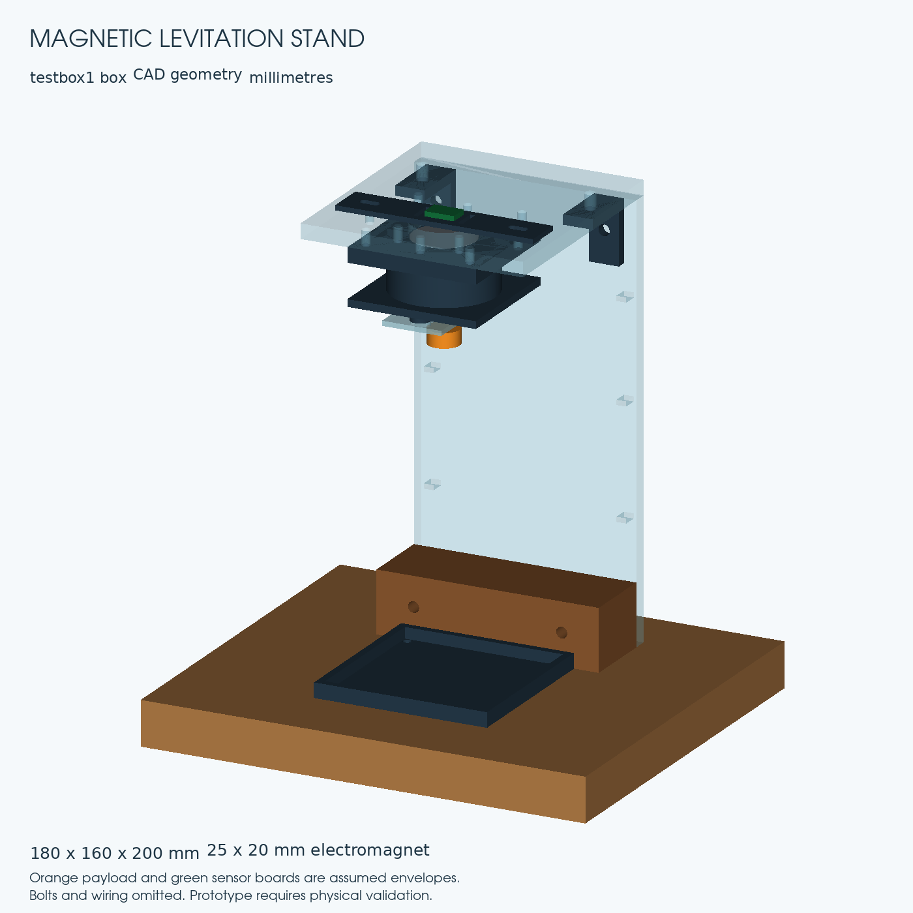
cad/testbox1_box/assembly_preview.png
