ENGR155/macroprocessors/cad/testbox1_box/dimensioned_assembly.png

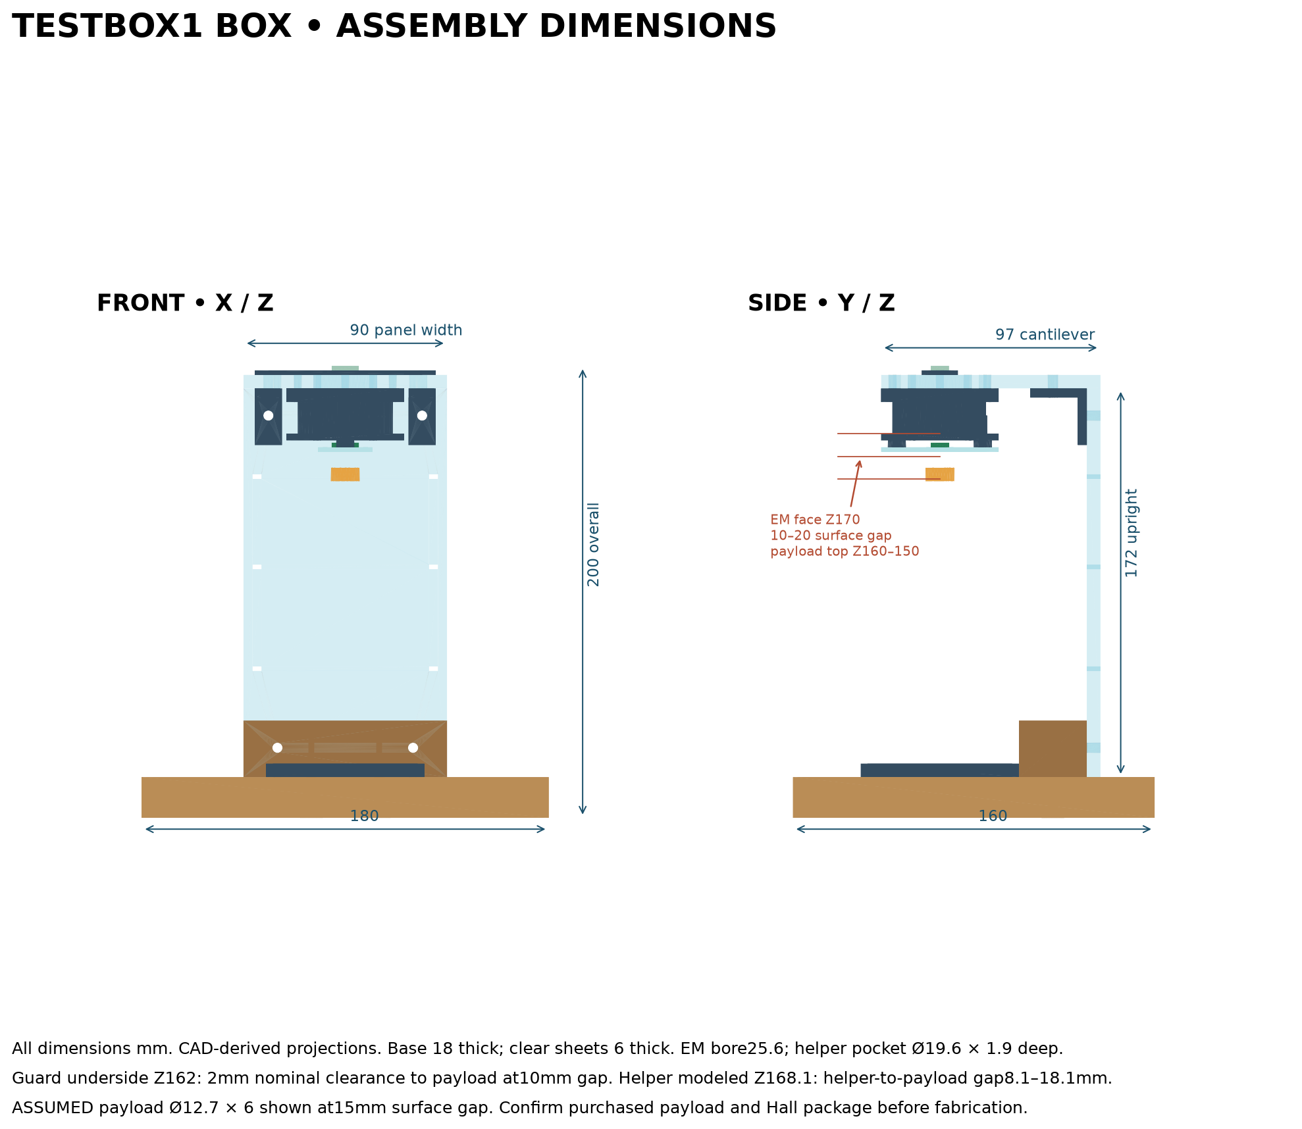
cad/testbox1_box/dimensioned_assembly.png
