ENGR155/macroprocessors/cad/testbox1_box/INPUT_EVIDENCE.md

# CAD input evidence — November 10, 2026

## Project sources read

The local Quarto portfolio (`index.qmd`, `hardware.qmd`, `design.qmd`, `results.qmd`, `about.qmd`), `docs/proposal.md`, `docs/hardware.md`, and the full revised `overleaf_10mm/proposal.tex` were read.

- Selected electromagnet: Heyiarbeit JF-XP2520-12V, nominal diameter 25 mm and height 20 mm.
- Fixed helper disk: nominal 3/4 inch diameter × 1/16 inch thickness, N42 (19.05 × 1.5875 mm).
- Moving magnet, carrier, and object: 10 g total; moving magnet dimensions remain unspecified.
- Commanded surface gap: 10–20 mm, measured from electromagnet bottom face to moving magnet top face. It is not measured from the helper or protective cover.
- Two Hall sensors: above and below the electromagnet. Exact ordering code/package is unconfirmed.
- Catch tray, upper stop, nonmagnetic frame required. Coil force, thermal behavior, final field calibration, and stable levitation are not yet verified in the portfolio.

## Purchase emails read

The HMC Gmail Kuali submission and order-update messages for requests 5159, 5160, 5161, and 5162 were read. They confirm KJMagnetics/KJMagnets, Amazon, and DigiKey orders but contain no line items, part dimensions, quantity, or mechanical drawings. Order notification alone cannot establish the purchased SKU. No matching detail was found in the personal Gmail search.

## External sources

- [Uzzors2k magnetic levitation project](http://uzzors2k.com/index.php?page=magneticlevitation): downloaded and read; completed and rear assembly photos inspected. Reference uses a clear broad upright bent into a top cantilever over a wooden base. Its coil is 40 mm diameter × 25 mm long; those coil dimensions do not apply to this project. Frame dimensions are not supplied. Reference mentions a 2 mm protective plastic Hall cover. The custom frame dimensions in these files are engineering choices, not dimensions extracted from the photographs. Reference attribution: Eirik Taylor / Uzzors2k, CC BY-NC-SA 4.0 as stated on the page.
- [K&J DC1](https://www.kjmagnetics.com/dc1-neodymium-disc-magnet): primary supplier listing matching the documented helper dimensions/grade, axial magnetization, ±0.1 mm dimensional tolerance, 3.39 g mass. This is a matching candidate; the emails do not prove DC1 is the purchased SKU.

## Fusion destination

The user clarified that “testbox1 box” is a folder for keeping the project together. Computer control returned “Computer Use was not approved to use fusion360.” A later Firefox read stopped Computer Use because browser URL policy enforcement is unsupported for that browser. No Fusion document was opened or modified, no cloud save was performed, and native Fusion execution cannot be represented as tested. Locally generated STEP files are the CAD deliverable for import into that folder; any Fusion script must be described as unexecuted unless separately validated in Fusion.
