ENGR155/macroprocessors/overleaf_10mm/assets/system_architecture.pdf

## Magnetic levitation: position PI drives PWM duty directly

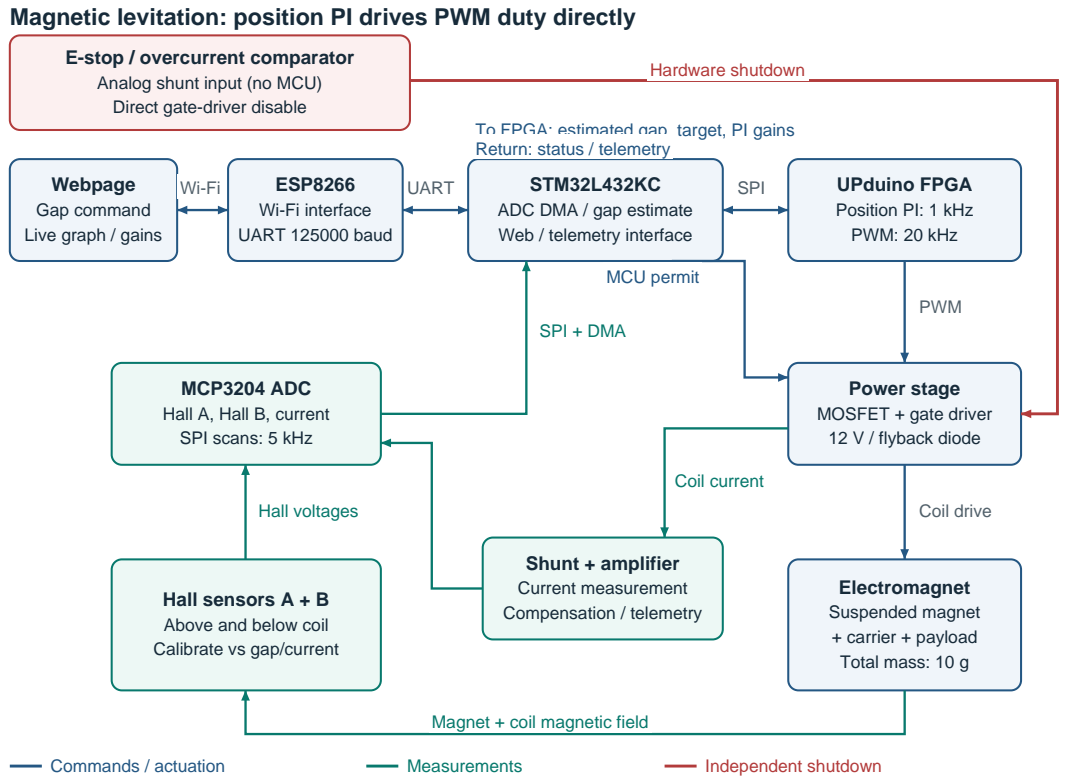
[picture p22: page 1]
Electromagnet Suspended magnet + carrier + payload Total mass: 10 g; Shunt + amplifier Current measurement Compensation / telemetry; UART; SPI; PWM; Coil drive; Hall voltages; SPI + DMA; Coil current; MCU permit; Hardware shutdown; Commands / actuation; Measurements; Independent shutdown

E-stop / overcurrent comparator
Analog shunt input (no MCU)
Direct gate-driver disable

To FPGA: estimated gap, target, PI gains
Return: status / telemetry
STM32L432KC
ADC DMA / gap estimate
Web / telemetry interface

Webpage
Gap command
Live graph / gains

ESP8266
Wi-Fi interface
UART 125000 baud

UPduino FPGA
Position PI: 1 kHz
PWM: 20 kHz

MCP3204 ADC
Hall A, Hall B, current
SPI scans: 5 kHz

Power stage
MOSFET + gate driver
12 V / flyback diode

Hall sensors A + B
Above and below coil
Calibrate vs gap/current

Magnet + coil magnetic field
