ENGR155/macroprocessors/(commit log)

2026-10-15 Initial Setup
    [bom.csv, calibration-format.csv, measurements.csv]
2026-11-08 Initial SPI
